igorofadown/PinCheck-4/ProductDesign/00122506_full_b1500.jpg

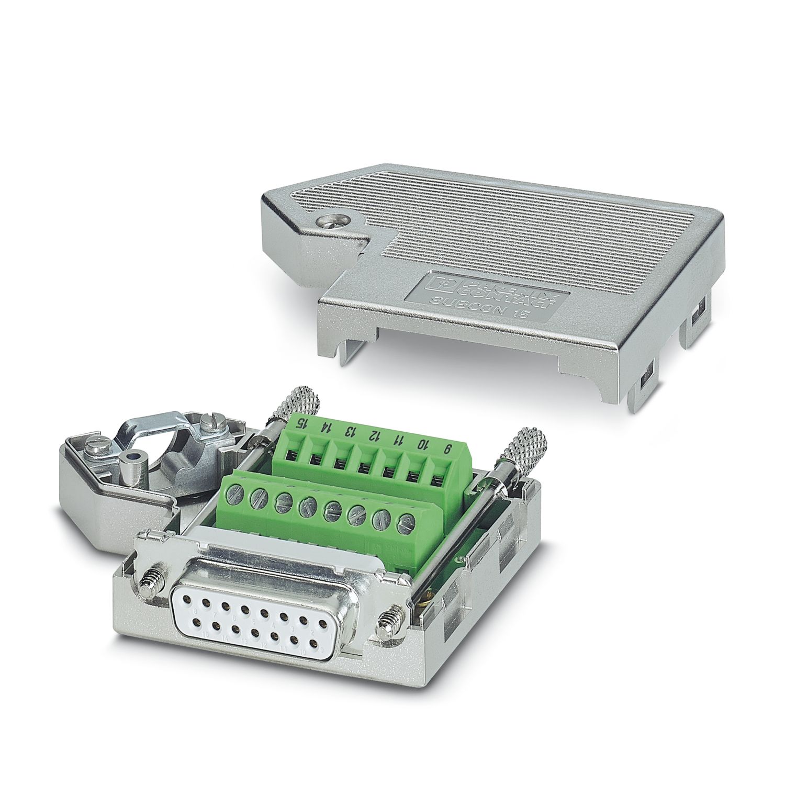
ProductDesign/00122506_full_b1500.jpg
