igorofadown/PinCheck-4/db15h4p_top_rev1.png

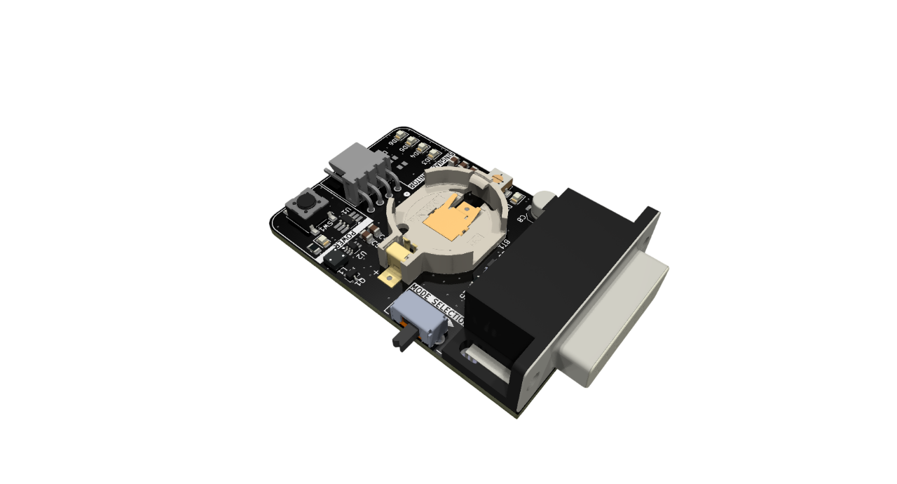
db15h4p_top_rev1.png
