igorofadown/PinCheck-4/design_ev/PinCheck-4_Rev1_img3.png

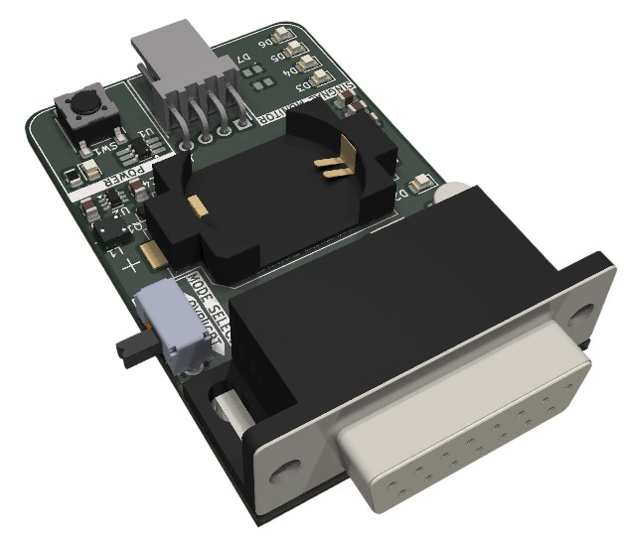
design_ev/PinCheck-4_Rev1_img3.png
