igorofadown/PinCheck-4/ProductDesign/00094506_full_b1500.jpg

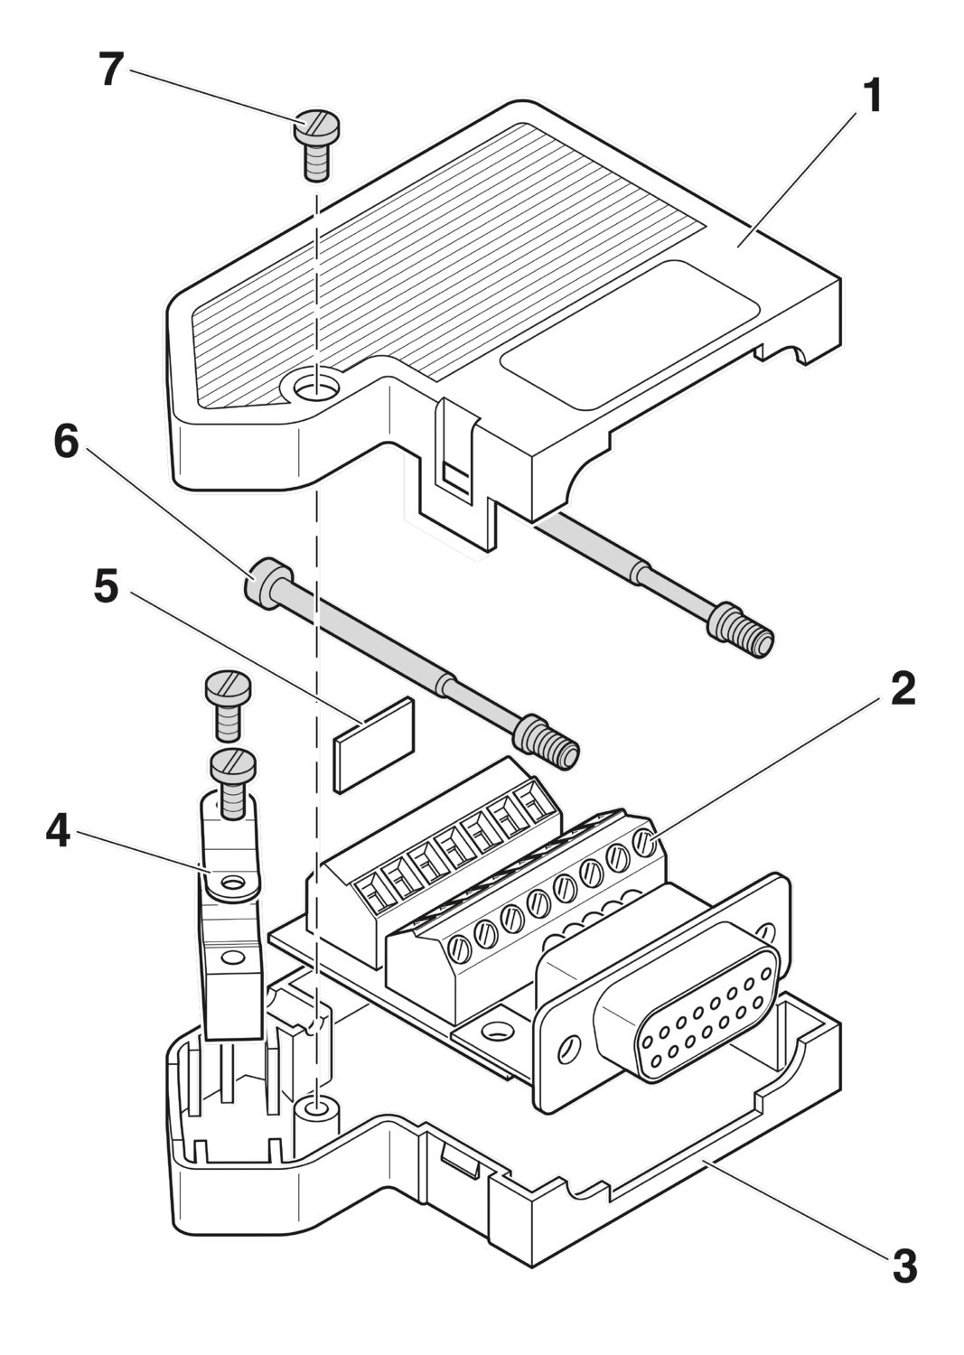
ProductDesign/00094506_full_b1500.jpg
