igorofadown/PinCheck-4/ProductDesign/00094509_full_b1500.jpg

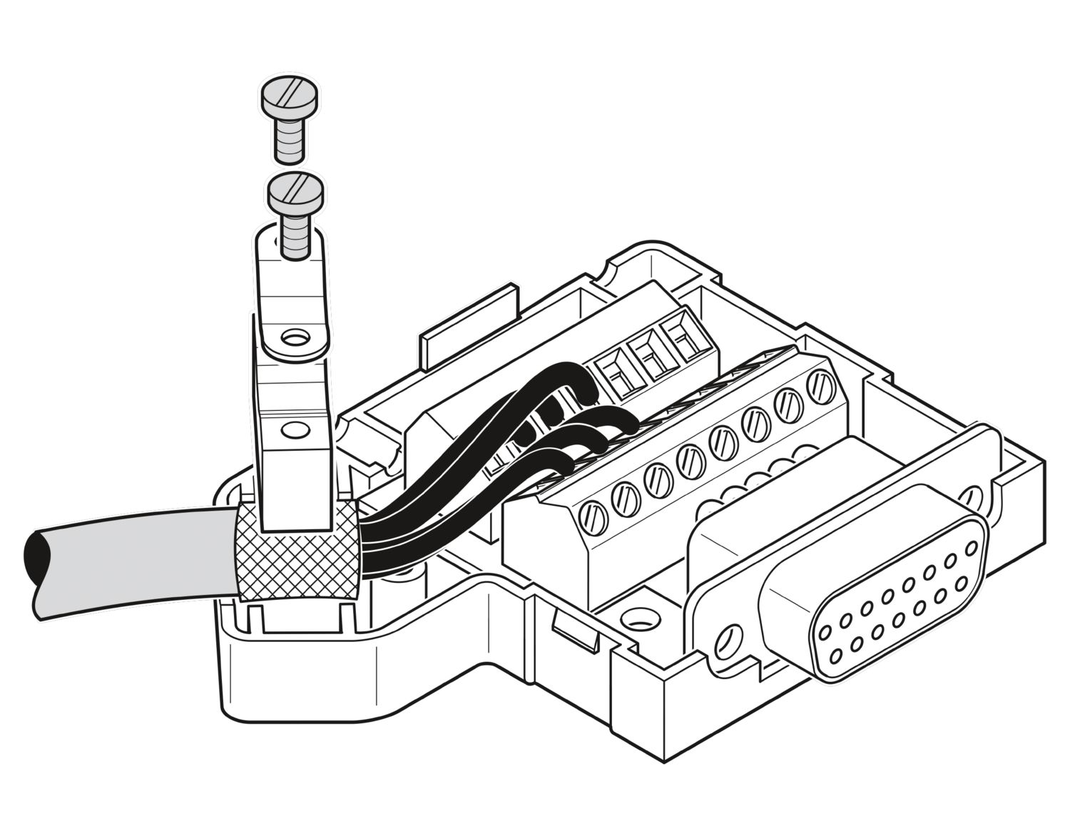
ProductDesign/00094509_full_b1500.jpg
