igorofadown/PinCheck-4/ProductDesign/MFG_5412_DTB-15MP-KIT_PT02_web(640x640).jpg

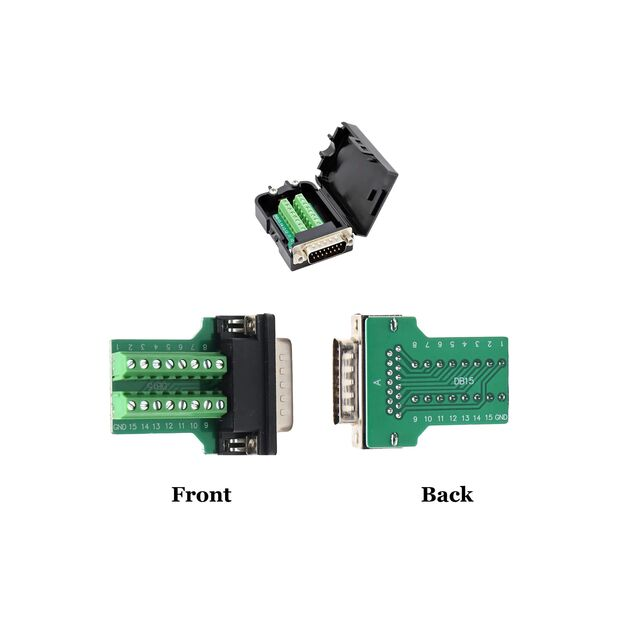
ProductDesign/MFG_5412_DTB-15MP-KIT_PT02_web(640x640).jpg
