igorofadown/PinCheck-4/(list of files, drawings)

Other design files:
Simulation/PinCheck-4.pdsprj
