igorofadown/PinCheck-4/PinCheck-4/PinCheck-4.kicad_pcb

## KiCad design PinCheck-4/PinCheck-4.kicad_pcb (2025-09-17)

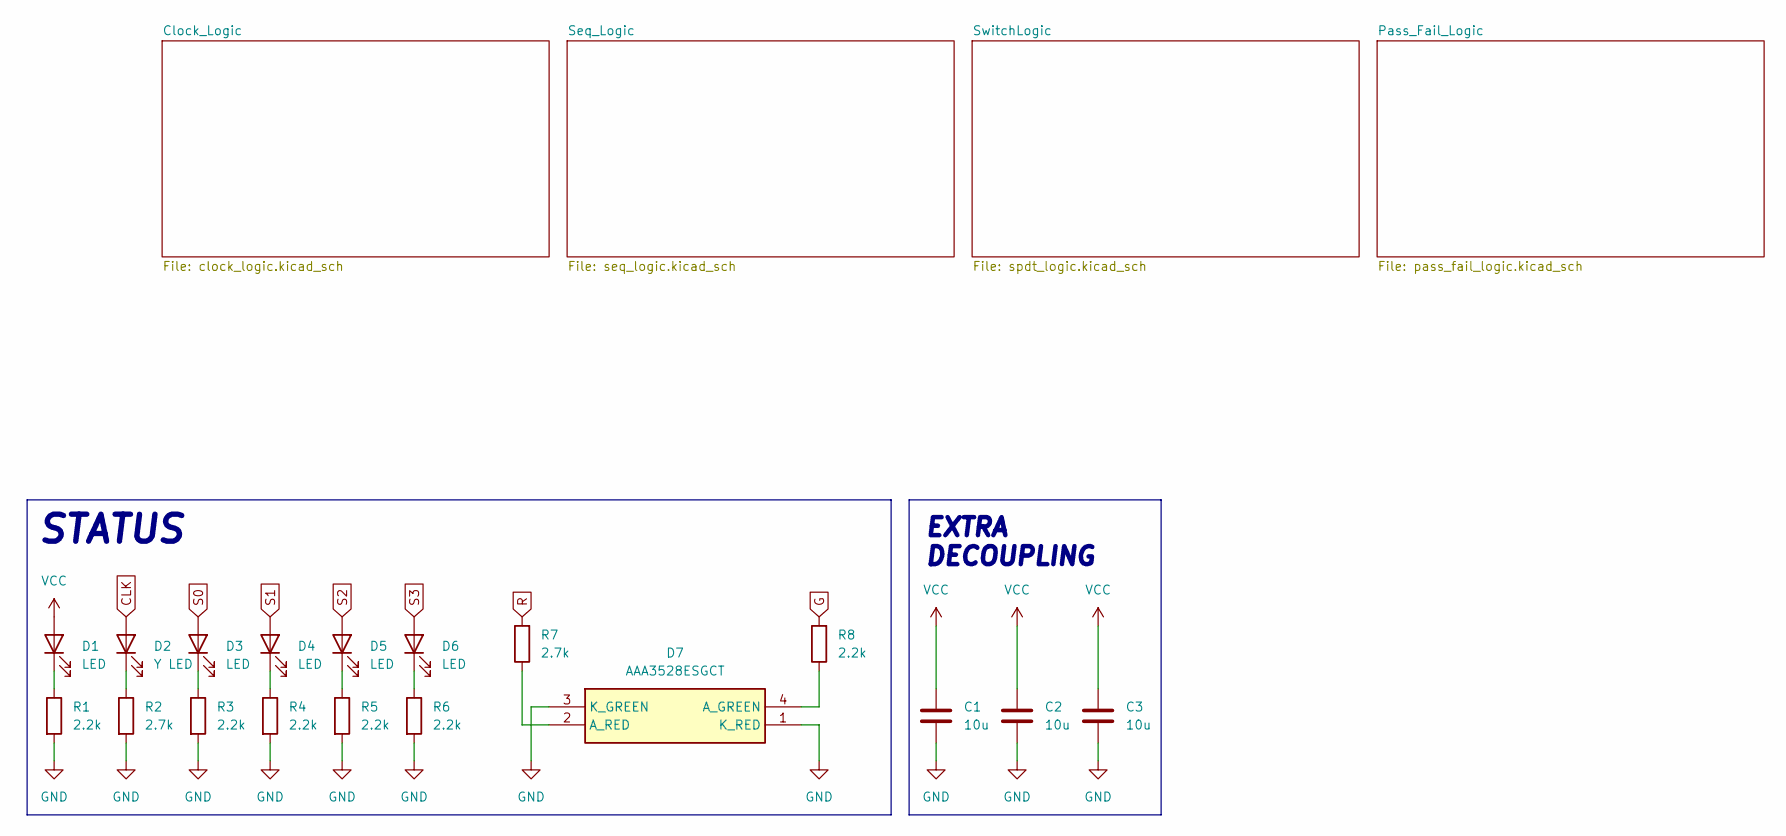
[picture p16: schematic PinCheck-4.kicad_sch, PinCheck - 4 Pin Cable (LEMHAL)]

Parts:
C1, C2, C3: 10u; C_0805_2012Metric
D1, D3, D4, D5, D6: LED; LED_0805_2012Metric; Manufacturer Part No KP-2012MGC
D2: Y LED; LED_0805_2012Metric; Manufacturer Part No KP-2012SECK
D7: AAA3528ESGCT; Manufacturer_Part_Number AAA3528ESGCT; Mouser Part Number 604-AAA3528ESGCT
R1, R3, R4, R5, R6, R8: 2.2k; R_0805_2012Metric; Manufacturer Part No MC01W080512K2
R2, R7: 2.7k; R_0805_2012Metric; Manufacturer Part No MCMR08X2701FTL

Connections:
CLK: D2.2 (A); also elsewhere on the board
G: R8.2; also elsewhere on the board
GND: C1.2, C2.2, C3.2, D7.1 (K_RED), D7.3 (K_GREEN), R1.2, R2.2, R3.2, R4.2, R5.2, R6.2; also elsewhere on the board
unnamed: D1.1 (K), R1.1
unnamed: D2.1 (K), R2.1
unnamed: D3.1 (K), R3.1
unnamed: D4.1 (K), R4.1
unnamed: D5.1 (K), R5.1
unnamed: D6.1 (K), R6.1
unnamed: D7.4 (A_GREEN), R8.1
unnamed: D7.2 (A_RED), R7.1
R: R7.2; also elsewhere on the board
S0: D3.2 (A); also elsewhere on the board
S1: D4.2 (A); also elsewhere on the board
S2: D5.2 (A); also elsewhere on the board
S3: D6.2 (A); also elsewhere on the board
VCC: C1.1, C2.1, C3.1, D1.2 (A); also elsewhere on the board

Notes on the sheet:
EXTRA DECOUPLING
STATUS

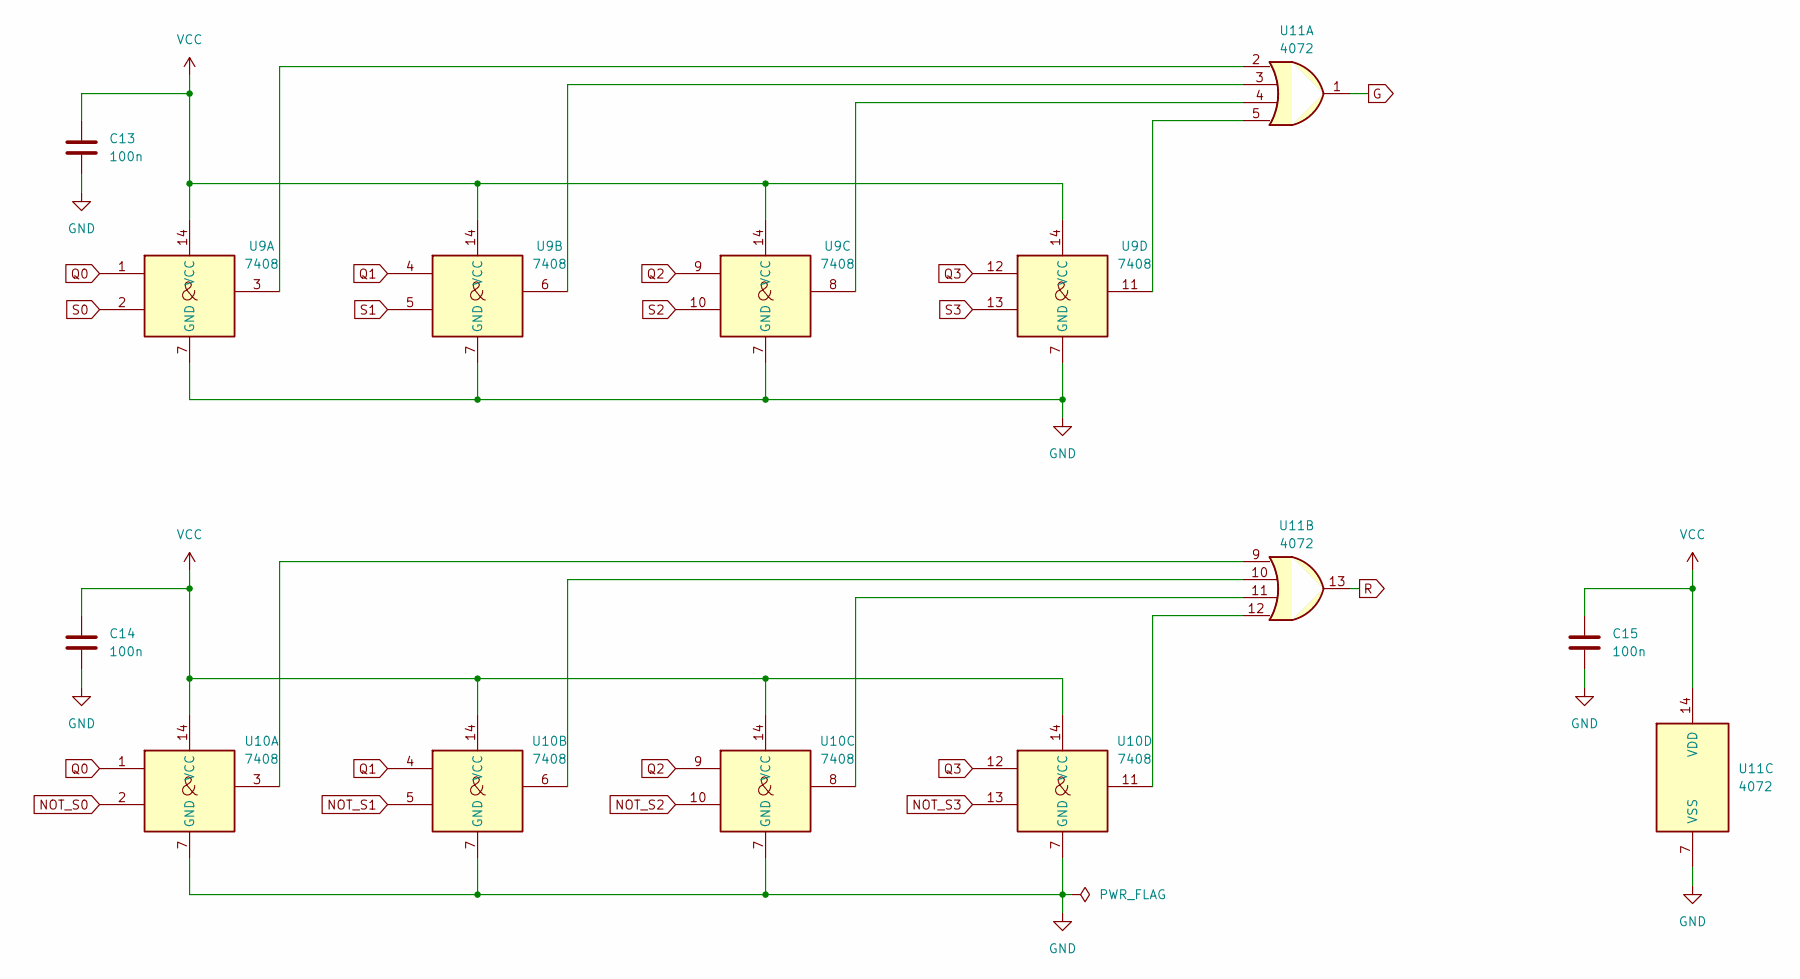
[picture p17: schematic pass_fail_logic.kicad_sch, PinCheck - 4 Pin Cable (LEMHAL)]

Parts:
C13, C14, C15: 100n; C_0805_2012Metric; Manufacturer Part No 0805B104K160CT
U9, U10: 7408; SOIC-14_3.9x8.7mm_P1.27mm; Manufacturer Part No 74HC08D
U11: 4072; SOIC-14_3.9x8.7mm_P1.27mm; Manufacturer Part No CD4072BM96

Connections:
G: U11.1; also elsewhere on the board
GND: C13.2, C14.2, C15.2, U9.7 (GND), U10.7 (GND), U11.7 (VSS); also elsewhere on the board
NOT_S0: U10.2; also elsewhere on the board
NOT_S1: U10.5; also elsewhere on the board
NOT_S2: U10.10; also elsewhere on the board
NOT_S3: U10.13; also elsewhere on the board
unnamed: U10.3, U11.9
unnamed: U10.6, U11.10
unnamed: U10.8, U11.11
unnamed: U10.11, U11.12
unnamed: U9.3, U11.2
unnamed: U9.6, U11.3
unnamed: U9.8, U11.4
unnamed: U9.11, U11.5
Q0: U9.1, U10.1; also elsewhere on the board
Q1: U9.4, U10.4; also elsewhere on the board
Q2: U9.9, U10.9; also elsewhere on the board
Q3: U9.12, U10.12; also elsewhere on the board
R: U11.13; also elsewhere on the board
S0: U9.2; also elsewhere on the board
S1: U9.5; also elsewhere on the board
S2: U9.10; also elsewhere on the board
S3: U9.13; also elsewhere on the board
VCC: C13.1, C14.1, C15.1, U9.14 (VCC), U10.14 (VCC), U11.14 (VDD); also elsewhere on the board

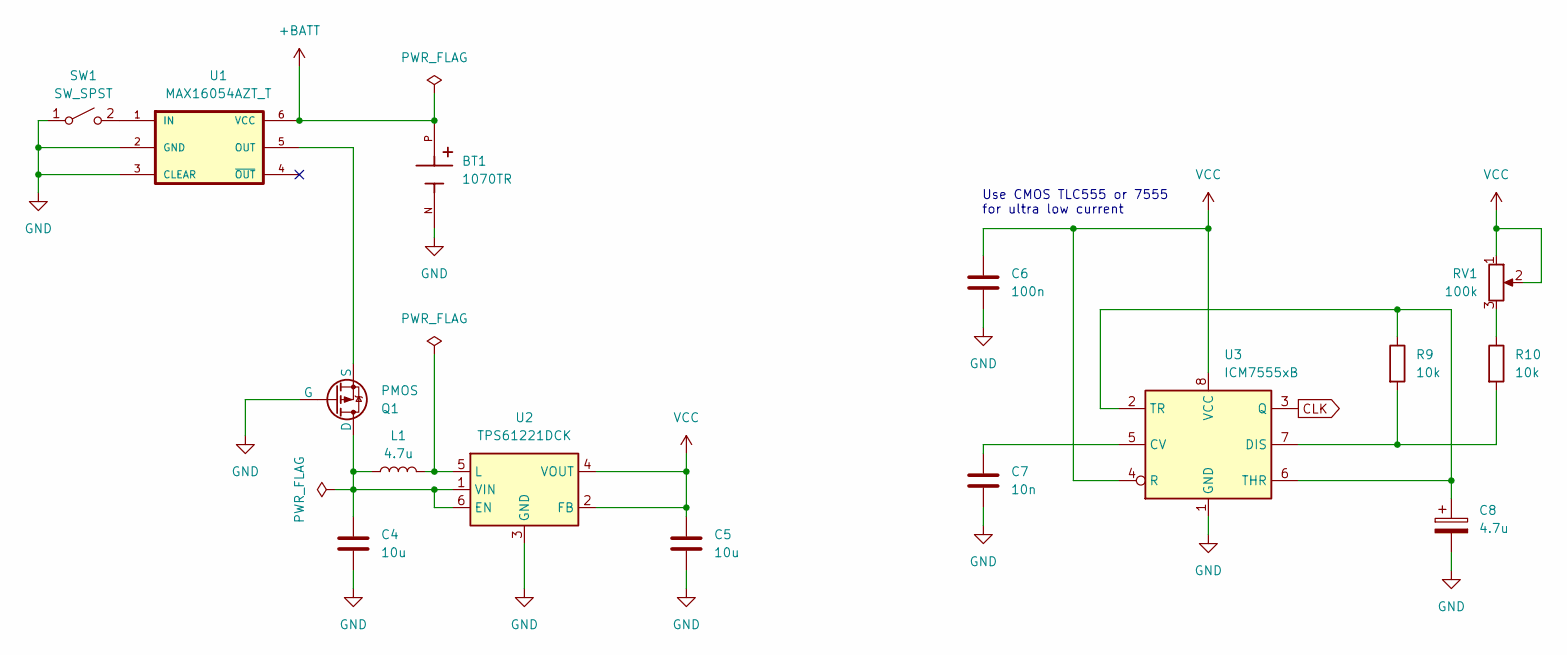
[picture p18: schematic clock_logic.kicad_sch, PinCheck - 4 Pin Cable (LEMHAL)]

Parts:
BT1: 1070TR; KEYSTONE_1070TR; PARTREV C
C4, C5: 10u; C_0805_2012Metric; Manufacturer Part No C2012X5R1C106M085AC
C6: 100n; C_0805_2012Metric; Manufacturer Part No 0805B104K160CT
C7: 10n; C_0805_2012Metric; Manufacturer Part No C0805S103K4RACTU
C8: 4.7u; CP_Elec_5x4.5; Manufacturer Part No EEE1EA4R7NR
L1: 4.7u; EPL3015472MLC; Manufacturer Part No EPL3015-472MLC
Q1: PMOS; SOT-323_SC-70; Manufacturer Part No AO3407A
R9, R10: 10k; R_0805_2012Metric; Manufacturer Part No CR0805-FX-1002ELF
RV1: 100k; Potentiometer_Bourns_3314G_Vertical; Manufacturer Part No 3314G-1-104E
SW1: SW_SPST; SW_SPST_PTS645Sx43SMTR92; Manufacturer Part No TS04-66-70-BK-160-SMT
U1: MAX16054AZT_T; TSOT-23-6_HandSoldering; Manufacturer Part No MAX16054AZT+T
U2: TPS61221DCK; Texas_R-PDSO-G6; Manufacturer Part No TPS61221DCKT
U3: ICM7555xB; SOIC-8_3.9x4.9mm_P1.27mm; Manufacturer Part No ICM7555ESA+T

Connections:
+BATT: BT1.P, U1.6 (VCC)
CLK: U3.3 (Q); also elsewhere on the board
GND: BT1.N, C4.2, C5.2, C6.2, C7.2, C8.2, Q1.1 (G), SW1.1 (A), U1.2 (GND), U1.3 (CLEAR), U2.3 (GND), U3.1 (GND); also elsewhere on the board
unnamed: C4.1, L1.1, Q1.3 (D), U2.1 (VIN), U2.6 (EN)
unnamed: Q1.2 (S), U1.5 (OUT)
unnamed: R10.1, RV1.3
unnamed: SW1.2 (B), U1.1 (IN)
unnamed: L1.2, U2.5 (L)
unnamed: C7.1, U3.5 (CV)
unnamed: R9.2, R10.2, U3.7 (DIS)
unnamed: C8.1, R9.1, U3.2 (TR), U3.6 (THR)
VCC: C5.1, C6.1, RV1.1, RV1.2, U2.2 (FB), U2.4 (VOUT), U3.4 (R), U3.8 (VCC); also elsewhere on the board

Notes on the sheet:
Use CMOS TLC555 or 7555 for ultra low current

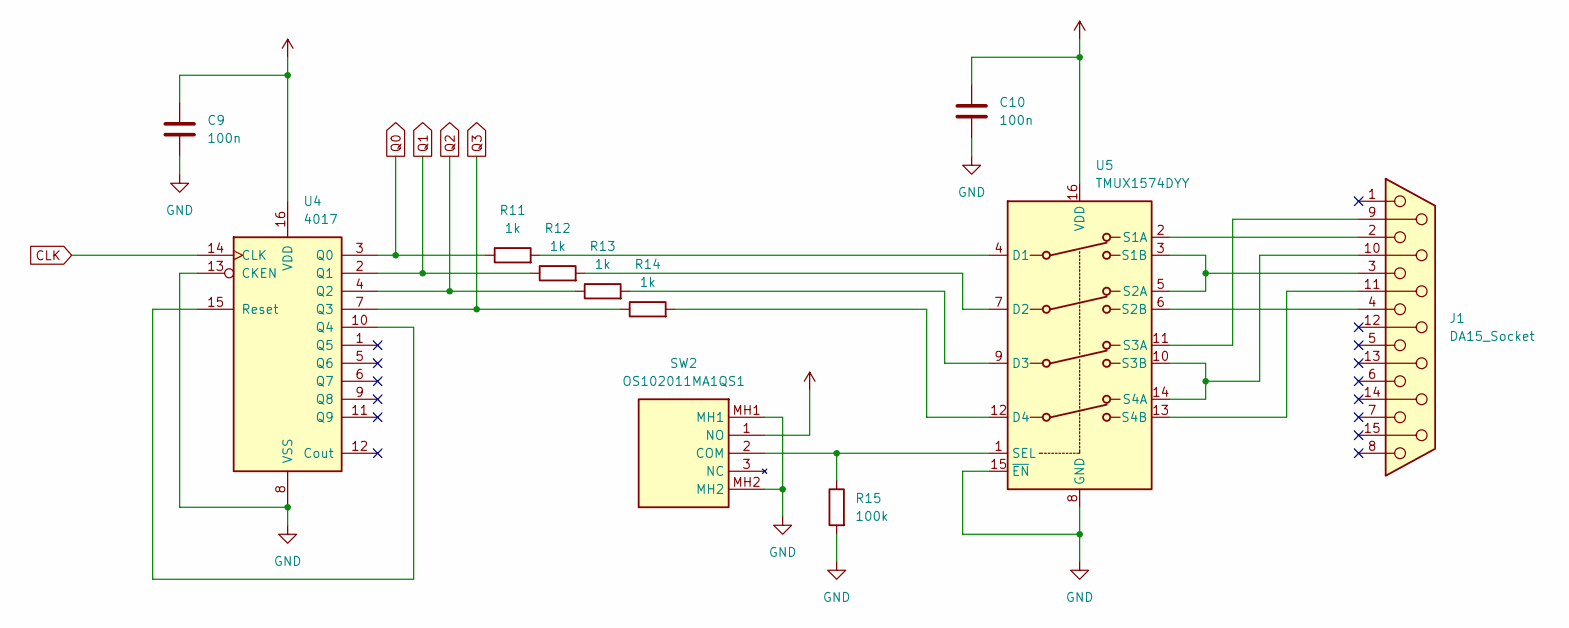
[picture p19: schematic spdt_logic.kicad_sch, PinCheck - 4 Pin Cable (LEMHAL)]

Parts:
C9, C10: 100n; C_0805_2012Metric; Manufacturer Part No 0805B104K160CT
J1: DA15_Socket; DSUB-15_Socket_Horizontal_P2.77x2.84mm_EdgePinOffset9.90mm_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; Manufacturer Part No MHDD15-F-T-B-S-R
R11, R12, R13, R14: 1k; R_0805_2012Metric; Manufacturer Part No MCMR08X1001FTL
R15: 100k; R_0805_2012Metric; Manufacturer Part No ERJP6WF1003V
SW2: OS102011MA1QS1; Manufacturer_Part_Number OS102011MA1QS1; Mouser Part Number N/A
U4: 4017; SOIC-16_3.9x9.9mm_P1.27mm; Manufacturer Part No CD4017BM96
U5: TMUX1574DYY; Texas_DYY0016A_TSOT-23-16_2x4.2mm_P0.5mm; Manufacturer Part No 4 Circuit IC Switch 2:1 4.5Ohm 16-SOT-2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

Connections:
CLK: U4.14 (CLK); also elsewhere on the board
GND: C9.2, C10.2, R15.2, SW2.MH1, SW2.MH2, U4.8 (VSS), U4.13 (CKEN), U5.8 (GND), U5.15 (~EN); also elsewhere on the board
unnamed: J1.9, U5.11 (S3A)
unnamed: J1.10, U5.10 (S3B), U5.14 (S4A)
unnamed: J1.11 (P111), U5.13 (S4B)
unnamed: R15.1, SW2.2 (COM), U5.1 (SEL)
unnamed: U4.10 (Q4), U4.15 (Reset)
unnamed: R11.2, U5.4 (D1)
unnamed: R12.2, U5.7 (D2)
unnamed: R13.2, U5.9 (D3)
unnamed: R14.2, U5.12 (D4)
unnamed: J1.2, U5.2 (S1A)
unnamed: J1.3, U5.3 (S1B), U5.5 (S2A)
unnamed: J1.4, U5.6 (S2B)
Q0: R11.1, U4.3 (Q0); also elsewhere on the board
Q1: R12.1, U4.2 (Q1); also elsewhere on the board
Q2: R13.1, U4.4 (Q2); also elsewhere on the board
Q3: R14.1, U4.7 (Q3); also elsewhere on the board
VCC: C9.1, C10.1, SW2.1 (NO), U4.16 (VDD), U5.16 (VDD); also elsewhere on the board

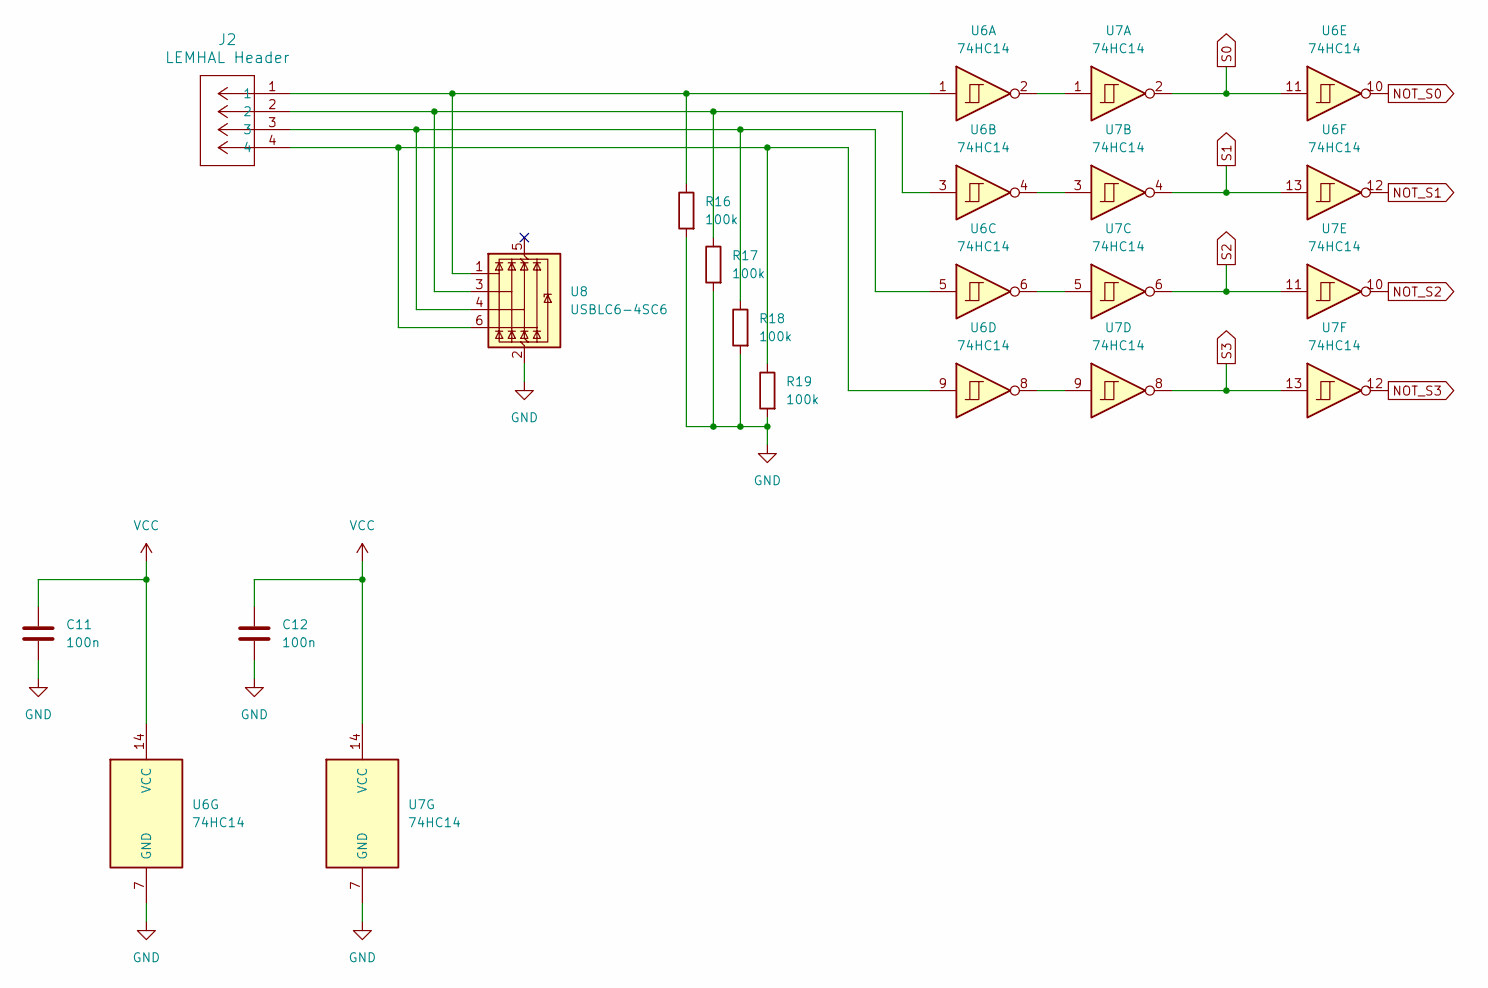
[picture p20: schematic seq_logic.kicad_sch, PinCheck - 4 Pin Cable (LEMHAL)]

Parts:
C11, C12: 100n; C_0805_2012Metric; Manufacturer Part No 0805B104K160CT
J2: LEMHAL Header; CONN_A-7478-04A_MOL; Manufacturer Part No 22-05-3041
R16, R17, R18, R19: 100k; R_0805_2012Metric; Manufacturer Part No ERJP6WF1003V
U6, U7: 74HC14; SOIC-14_3.9x8.7mm_P1.27mm; Manufacturer Part No 74HC14D
U8: USBLC6-4SC6; SOT-23-6; Manufacturer Part No USBLC6-4SC6

Connections:
GND: C11.2, C12.2, R16.2, R17.2, R18.2, R19.2, U6.7 (GND), U7.7 (GND), U8.2 (GND); also elsewhere on the board
NOT_S0: U6.10; also elsewhere on the board
NOT_S1: U6.12; also elsewhere on the board
NOT_S2: U7.10; also elsewhere on the board
NOT_S3: U7.12; also elsewhere on the board
unnamed: U6.2, U7.1
unnamed: U6.4, U7.3
unnamed: U6.6, U7.5
unnamed: U6.8, U7.9
unnamed: J2.1, R16.1, U6.1, U8.1 (I/O1)
unnamed: J2.2, R17.1, U6.3, U8.3 (I/O2)
unnamed: J2.3, R18.1, U6.5, U8.4 (I/O3)
unnamed: J2.4, R19.1, U6.9, U8.6 (I/O4)
S0: U6.11, U7.2; also elsewhere on the board
S1: U6.13, U7.4; also elsewhere on the board
S2: U7.6, U7.11; also elsewhere on the board
S3: U7.8, U7.13; also elsewhere on the board
VCC: C11.1, C12.1, U6.14 (VCC), U7.14 (VCC); also elsewhere on the board

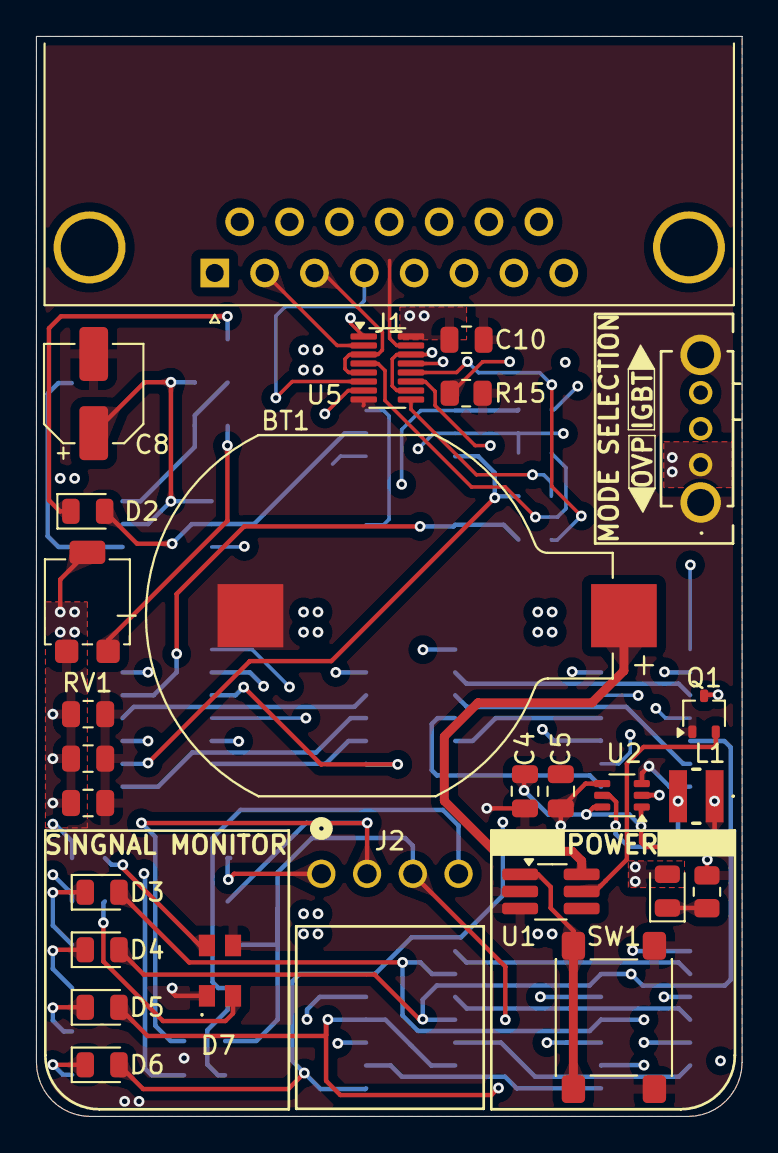
[picture p21: board PinCheck-4.kicad_pcb from above]

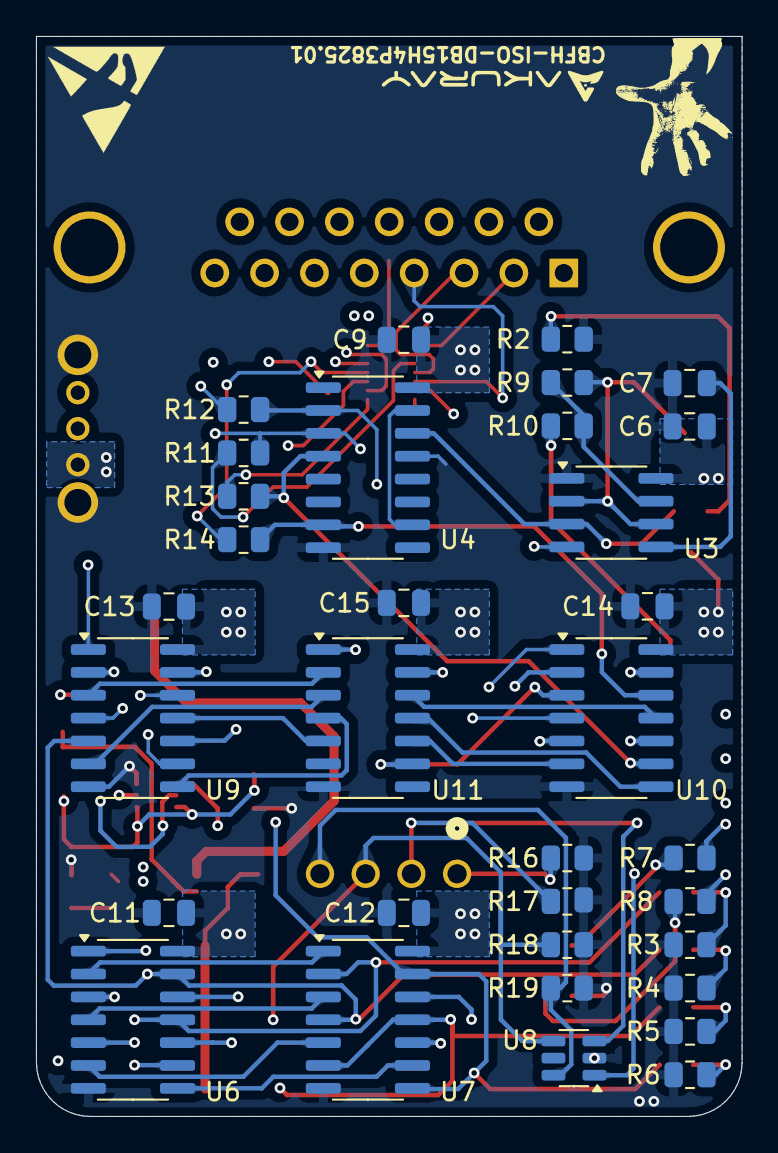
[picture p22: board PinCheck-4.kicad_pcb from below]

Board: 4 copper layers, 39.2 x 60.0 mm, 60 parts (33 on the bottom side), 62 nets.
