igorofadown/PinCheck-4/(commit log)

2025-08-26 Daily sync 2025-08-26 16:39
    [PinCheck-4.kicad_pcb, PinCheck-4.kicad_sch]
2025-08-27 Daily sync 2025-08-27 12:04
    [PinCheck-4.kicad_sch, clock_logic.kicad_sch, fail_logic.kicad_sch, pass_logic.kicad_sch, seq_logic.kicad_sch]
2025-08-27 Daily sync 2025-08-27 16:57
    [PinCheck-4.kicad_pcb, PinCheck-4.kicad_sch, clock_logic.kicad_sch, fail_logic.kicad_sch, pass_logic.kicad_sch, seq_logic.kicad_sch, spdt_logic.kicad_sch]
2025-08-27 Daily sync 2025-08-27 22:21
    [PinCheck-4.kicad_sch, pass_fail_logic.kicad_sch]
2025-08-28 Daily sync 2025-08-28 16:55
    [PinCheck-4.kicad_pcb, clock_logic.kicad_sch, pass_fail_logic.kicad_sch, seq_logic.kicad_sch]
2025-08-29 Daily sync 2025-08-29 22:48
    [PinCheck-4.kicad_pcb, PinCheck-4.kicad_sch, clock_logic.kicad_sch, pass_fail_logic.kicad_sch, seq_logic.kicad_sch, spdt_logic.kicad_sch]
2025-08-30 Daily sync 2025-08-30 13:49
    [PinCheck-4.kicad_pcb, PinCheck-4.kicad_sch, clock_logic.kicad_sch, pass_fail_logic.kicad_sch, seq_logic.kicad_sch, spdt_logic.kicad_sch]
2025-08-30 Daily sync 2025-08-30 21:30
    [PinCheck-4.kicad_pcb, PinCheck-4.kicad_sch, PinCheck-4.pdsprj, clock_logic.kicad_sch]
2025-08-31 Daily sync 2025-08-31 12:14
    [PinCheck-4.kicad_pcb, PinCheck-4.kicad_sch, clock_logic.kicad_sch, pass_fail_logic.kicad_sch, seq_logic.kicad_sch, spdt_logic.kicad_sch]
2025-08-31 Daily sync 2025-08-31 15:53
    [PinCheck-4.pdsprj]
2025-08-31 Daily sync 2025-08-31 16:37
    [PinCheck-4.kicad_pcb]
2025-09-01 Daily sync 2025-09-01 09:07
    [PinCheck-4.kicad_pcb, PinCheck-4.kicad_sch, clock_logic.kicad_sch]
2025-09-01 Daily sync 2025-09-01 11:59
    [PinCheck-4.csv, PinCheck-4.kicad_pcb, PinCheck-4.kicad_sch, clock_logic.kicad_sch, seq_logic.kicad_sch, spdt_logic.kicad_sch]
2025-09-16 Daily sync 2025-09-16 16:52
    [PinCheck-4.kicad_pcb]
2025-09-17 Daily sync 2025-09-17 12:09
    [PinCheck-4-B_Cu.gbr, PinCheck-4-B_Mask.gbr, PinCheck-4-B_Paste.gbr, PinCheck-4-B_Silkscreen.gbr, PinCheck-4-Edge_Cuts.gbr, PinCheck-4-F_Cu.gbr, PinCheck-4-F_Mask.gbr, PinCheck-4-F_Paste.gbr]
2025-09-17 Daily sync 2025-09-17 15:01
    [PinCheck-4-B_Cu.gbr, PinCheck-4-B_Mask.gbr, PinCheck-4-B_Paste.gbr, PinCheck-4-B_Silkscreen.gbr, PinCheck-4-Edge_Cuts.gbr, PinCheck-4-F_Cu.gbr, PinCheck-4-F_Mask.gbr, PinCheck-4-F_Paste.gbr]
